dilsatabdusev11-droid/balancing-robot/hardware/stl/tt_motor_holder.stl

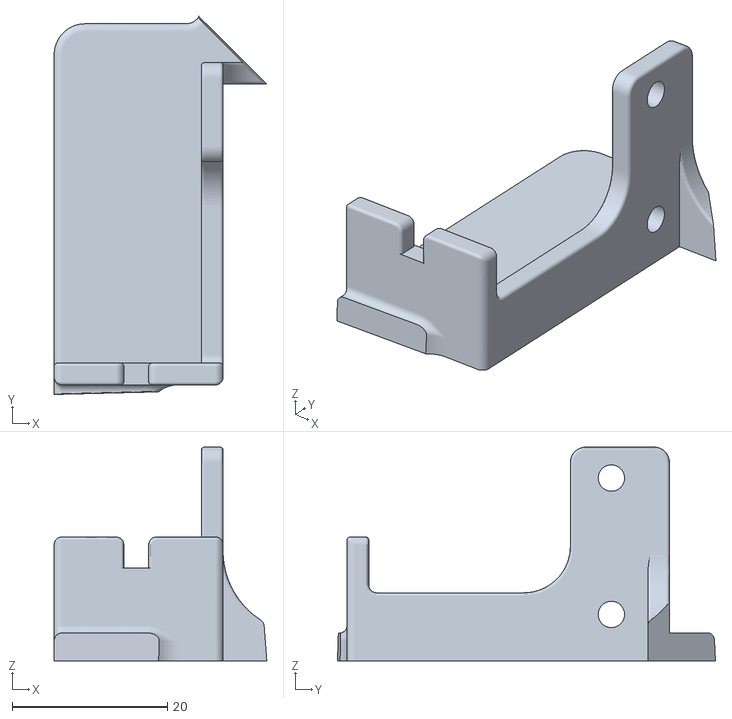
[picture p3: CAD file, 2026-10-14]
hardware/stl/tt_motor_holder.stl
27.4 x 48.8 x 27.6
