dilsatabdusev11-droid/balancing-robot/(commit log)

2026-10-14 Restructure repo: sketch folder, config.h, asset folders
    - Move the sketch into firmware/self_balancing_robot/ so the Arduino IDE
    opens it without asking to create a folder.
    - Move pins, motor polarity and IMU axes into config.h; motor polarity is
    now two flags instead of hard-coded branches (behavior unchanged).
    - Rename the STL without spaces (README pointed at a name that did not
    exist) and move images and the schematic to docs/images/.
    - Replace the C++/CMake .gitignore template with Arduino-relevant entries.
    - Replace the chat-style changelog in the sketch header with a short
    description.
    Claude-Session: https://claude.ai/code/session_01EfDxCgzaS5rB8Aqg22rSNy
    [tt_motor_holder.stl]
2026-10-14 Stop serial tuning from freezing the robot; save settings to flash
    Serial.parseFloat() waits up to 1 s for the next character, so every
    tuning command (e.g. 'p15' + Enter) paused the balance loop for about a
    second with the motors still running, and the robot fell over.
    - Collect Serial input into a line without waiting (LineReader) and parse
    'name value' commands; the original one-letter commands still work.
    - Keep all tunable values in a Settings struct with allowed ranges;
    out-of-range values are clamped and reported.
    - New commands: show/?, save, defaults, help. Saved values are loaded
    from NVS (Preferences) at boot.
    - Add host-side unit tests (tests/host/run.sh) for the parser an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
2026-10-14 Smooth motor output, move ENB off GPIO12, TB6612 and battery support
    - Motor duty no longer jumps from 0 to 70 for any command above 0.05:
    below a small start command the duty grows from 0, above it the
    friction offset applies. The old step made the wheels chatter around
    the balance point.
    - Motor code moves to motors.cpp. Positive commands now mean 'drive
    forward' (the side the robot leans to when the angle grows); the PID
    error sign and both motor flags are flipped so behavior is unchanged.
    - ENB moves from GPIO12 to GPIO13: GPIO12 is a strapping pin and the
    board does not boot if it is pulled HIGH at reset.
    - Optional TB6612FNG STBY pin.
    - Optional battery monitor (divider on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
    [battery.cpp, battery.h, config.h, drive_math.h, motors.cpp, motors.h, self_balancing_robot.ino, test_drive_math.cpp]
2026-10-14 Calibrate the gyro, filter by time constant, fixed 200 Hz loop
    - Read the MPU-6050 registers directly (imu.cpp): every I2C error is now
    detected. One failed read keeps the last motor command, three in a row
    stop the motors and the sensor is re-initialised every 0.5 s. A missing
    IMU at boot no longer hangs the board. Adafruit libraries are no longer
    needed.
    - Measure the gyro offset for 1 s at boot (and with 'calib'); retry if
    the robot moves. Uncorrected, 2 deg/s of offset left a steady 1 deg
    angle error that made the robot roll away.
    - Complementary filter uses a time constant (0.5 s) instead of a fixed
    0.96/0.04 split, so its response no longer depends on loop speed, and
    it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
    [config.h, control.h, imu.cpp, imu.h, self_balancing_robot.ino, test_control.cpp, tuning.cpp]
2026-10-14 Safe start, emergency stop, gyro-rate D term, bounded auto-trim
    - Arming state machine (balance.h): the motors start only after the
    robot is held within 5 deg of upright for 0.5 s - after boot, a fall,
    an emergency stop or an IMU fault. Before, a robot lying at 25 deg or
    being picked up restarted at full power.
    - Emergency stop: 'stop'/'go' on Serial, X/G from the phone.
    - The PID's D term uses the gyro tilt rate instead of differentiating the
    error: no noise amplification and no output kick (one step of ~440
    units) when the target jumps or the controller restarts. Output is
    limited to +-100 and the integral does not wind up while saturated.
    - Auto-trim had the wrong sign (positi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
    [balance.h, config.h, self_balancing_robot.ino, test_balance.cpp, tuning.cpp]
2026-10-14 Optional wheel encoders with a speed loop
    Without encoders the robot only holds its angle, so it slowly rolls
    away and cannot stand on one spot. With ENCODERS_ENABLED (off by
    default, the original build has none):
    - encoders.cpp counts rising edges of channel A (channel B gives the
    direction) on both wheels.
    - WheelSpeed turns counts into a smoothed forward speed in m/s.
    - SpeedLoop (outer loop) turns the speed error into a lean angle for the
    balance PID; its integral keeps the robot on one spot and replaces
    auto-trim. The phone now sets a speed (vmax) instead of a lean.
    - New settings vkp, vki, vmax (settings version 2: previously saved
    values are reset to defaults) and an 'encoder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
    [balance.h, config.h, encoders.cpp, encoders.h, self_balancing_robot.ino, settings.h, test_balance.cpp, tuning.cpp]
2026-10-14 Phone remote: unique robot names, Wi-Fi web pad, plotter output
    - Every robot is named BalanceBot-XXXX from its own MAC address instead
    of 'DengeRobot', so a classroom of robots no longer shows identical
    Bluetooth names.
    - REMOTE_MODE in config.h: classic Bluetooth (as before, Android only,
    original ESP32 only, dropped by default in ESP32 core 4.x) or Wi-Fi:
    the robot opens its own access point and serves a control page with
    hold-to-drive arrows, STOP/GO and live state, angle, speed and
    battery. It works in any phone browser, iPhone included, and on every
    ESP32 variant.
    - Both remotes feed the same command handler (W/S/A/D/L, X stop, G go).
    - 'log 0|1|2': no output, text, or Ar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
    [config.h, console.ino, remote.cpp, remote.h, self_balancing_robot.ino, tuning.cpp]
2026-10-14 Take encoder counts every step, even when an IMU read is skipped
    A skipped step left its counts for the next one, which then divided two
    steps of counts by one dt and showed a short speed spike.
    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
    [self_balancing_robot.ino]
2026-10-14 Russian README with wiring, power and setup guide; CI workflow
    - README rewritten in Russian for the robotics course: parts list with
    the recommended TB6612FNG, BMS, fuse and separate 5 V buck converter
    for the ESP32 (the L298N regulator sagged under motor load), updated
    pinout (ENB on GPIO13, STBY, battery divider, encoders), power
    diagram, step-by-step first start (gyro, sensor sign, motor test,
    balance point, PID tuning), phone remote, command reference,
    troubleshooting and a table of what was fixed versus the original.
    - Screenshot of the Wi-Fi remote page; its status now shows the state
    and the values on two lines.
    - GitHub Actions: host unit tests, and firmware builds for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
    [config.h]
